ETML-ES-SLO/PRJ_2226_Kit_RegulationThermique/2226A/doc/Canevas Rapport.docx

2226_RegThermique

Pré-étude

Nom du document : 2226_RegThermique_TAN_v1.pdf

Réalisé par : Taulant Neziri

A l'attention de Mr. Braun

Date de début : 30 Novembre 2022

Date de fin : 07 Décembre 2022

# Table des matières

# Cahier des charges

# Pré-étude

## A. Résumé du projet

## B. Schéma général du système

# HMI (Human Machine Interaction)

# Spécifications (Choix technologiques)

## C. Corps de chauffe

ETML-ES 2226_RegThermique TAN Pré-étude
