ETML-ES-SLO/PRJ_2226_Kit_RegulationThermique/2226A/doc/MERGE FINAL/Affiche_2226_Regthermique.pdf

Taulant Neziri
TECHNICIEN-NE ES EN GÉNIE ÉLECTRIQUE / 2022-2023

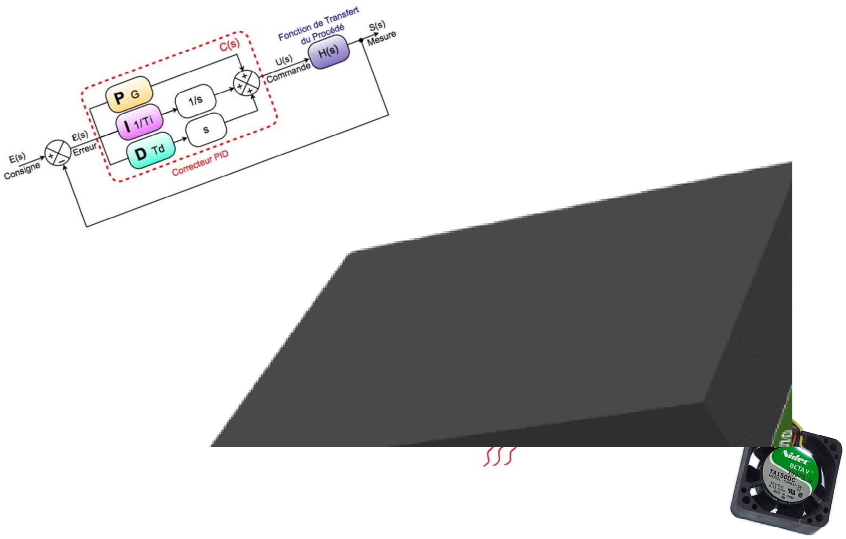
[picture p70: figure]

www.etml-es.ch
rue de Sébeillon 12, 1004 Lausanne | ETML

Régulation thermique

Le but de ce projet est de concevoir un système de régulation thermique dans un boîtier fermé pour les cours de réglage.

L’utilisateur aura deux possibilités de réglages. La première pourra être effectuer via un générateur externe et des touches physiques (bouton, potentiomètre). La deuxième, se fera via USB.

Ce projet m’a permis de développer un produit partant d’une idée sous forme de cahier charges jusqu’à avoir un produit qui pourra être livrable. Le projet n’est pas
complément fini. Les diverses périphériques du système sont fonctionnels, mais la régulation n’a pas pu être traité complètement, et n’est donc pas fonctionnelle.

Malgré les difficultés rencontrés, ce projet m’a apporté de très bonnes connaissances en ce qui concerne la gestion de projet, et a approfondi aussi mes connaissances en dimensionnement et design de schéma électrique ainsi que la conception de PCB.
