ETML-ES-SLO/PRJ_2226_Kit_RegulationThermique/2226A/doc/MERGE FINAL/system_interrupt.pdf

/******************************************************************************* System Interrupts File

File Name:
system_interrupt.c

Summary:
Raw ISR definitions.

Description:
This file contains a definitions of the raw ISRs required to support the interrupt sub-system.

Summary:
This file contains source code for the interrupt vector functions in the system.

Description:
This file contains source code for the interrupt vector functions in the system. It implements the system and part specific vector "stub" functions from which the individual "Tasks" functions are called for any modules executing interrupt-driven in the MPLAB Harmony system.

Remarks:
This file requires access to the systemObjects global data structure that contains the object handles to all MPLAB Harmony module objects executing interrupt-driven in the system. These handles are passed into the individual module "Tasks" functions to identify the instance of the module to maintain. *******************************************************************************/

// DOM-IGNORE-BEGIN
/******************************************************************************* Copyright (c) 2011-2014 released Microchip Technology Inc. All rights reserved.

Microchip licenses to you the right to use, modify, copy and distribute Software only when embedded on a Microchip microcontroller or digital signal controller that is integrated into your product or third party product (pursuant to the sublicense terms in the accompanying license agreement).

You should refer to the license agreement accompanying this Software for additional information regarding your rights and obligations.

SOFTWARE AND DOCUMENTATION ARE PROVIDED "AS IS" WITHOUT WARRANTY OF ANY KIND, EITHER EXPRESS OR IMPLIED, INCLUDING WITHOUT LIMITATION, ANY WARRANTY OF

C:/microchip/harmony/v2_06/apps/MINF/PROJ_RegTherm/firmware/src/system_config/default/system_interrupt.c

1.1 of 6 | 2023.05.24 09:24:42

C:/microchip/harmony/v2_06/apps/MINF/PROJ_RegTherm/firmware/src/system_config/default/system_interrupt.c

1.2 of 6 | 2023.05.24 09:24:42

MERCHANTABILITY, TITLE, NON-INFRINGEMENT AND FITNESS FOR A PARTICULAR PURPOSE. IN NO EVENT SHALL MICROCHIP OR ITS LICENSORS BE LIABLE OR OBLIGATED UNDER CONTRACT, NEGLIGENCE, STRICT LIABILITY, CONTRIBUTION, BREACH OF WARRANTY, OR OTHER LEGAL EQUITABLE THEORY ANY DIRECT OR INDIRECT DAMAGES OR EXPENSES INCLUDING BUT NOT LIMITED TO ANY INCIDENTAL, SPECIAL, INDIRECT, PUNITIVE OR CONSEQUENTIAL DAMAGES, LOST PROFITS OR LOST DATA, COST OF PROCUREMENT OF SUBSTITUTE GOODS, TECHNOLOGY, SERVICES, OR ANY CLAIMS BY THIRD PARTIES (INCLUDING BUT NOT LIMITED TO ANY DEFENSE THEREOF), OR OTHER SIMILAR COSTS. *******************************************************************************/ // DOM-IGNORE-END

// ***************************************************************************** // ***************************************************************************** // Section: Included Files
// ***************************************************************************** // *****************************************************************************

#include "system/common/sys_common.h"

#include "app.h"

#include "system_definitions.h"

// ***************************************************************************** // ***************************************************************************** // Section: System Interrupt Vector Functions
// ***************************************************************************** // *****************************************************************************

void __ISR(_TIMER_1_VECTOR, ipl2AUTO) IntHandlerDrvTmrInstance0(void) {
PLIB_INT_SourceFlagClear(INT_ID_0,INT_SOURCE_TIMER_1);

static int count= 0;

if(count < 3000)
{
count ++;
}
else
{
APP_UpdateState(APP_STATE_SERVICE_TASKS); }

C:/microchip/harmony/v2_06/apps/MINF/PROJ_RegTherm/firmware/src/system_config/default/system_interrupt.c

2.1 of 6 | 2023.05.24 09:24:42

C:/microchip/harmony/v2_06/apps/MINF/PROJ_RegTherm/firmware/src/system_config/default/system_interrupt.c

2.2 of 6 | 2023.05.24 09:24:42

}
void __ISR(_TIMER_2_VECTOR, ipl1AUTO) IntHandlerDrvTmrInstance1(void) {
PLIB_INT_SourceFlagClear(INT_ID_0,INT_SOURCE_TIMER_2);
}
void __ISR(_TIMER_3_VECTOR, ipl1AUTO) IntHandlerDrvTmrInstance2(void) {
PLIB_INT_SourceFlagClear(INT_ID_0,INT_SOURCE_TIMER_3);
}

/******************************************************************************* End of File
*/

C:/microchip/harmony/v2_06/apps/MINF/PROJ_RegTherm/firmware/src/system_config/default/system_interrupt.c

3.1 of 6 | 2023.05.24 09:24:42

C:/microchip/harmony/v2_06/apps/MINF/PROJ_RegTherm/firmware/src/system_config/default/system_interrupt.c

3.2 of 6 | 2023.05.24 09:24:42
