ETML-ES-SLO/PRJ_2226_Kit_RegulationThermique/2226A/hard/2226_RegThermique_BOM.xlsx

2226_RegThermique BOM
Designation | Qty | Description | Package Type | Mfr.Part No. | Supplier.Part No. | Price (per unit) | Total price | Supplier
U4 | 1 | PIC32MX250F128D-I/PT | TQFP-PT44 | PIC32MX250F128DT-I/PT | 579-32MX250F128DTIPT | 5.20 CHF | 5.20 CHF | Mouser
U1,U2,U3 | 3 | MAX6612MXK+T | SOT23 | MAX6612MXK+T | 700-MAX6612MXKT | 2.09 CHF | 6.27 CHF | Mouser
U5,U6,U7 | 3 | TL052ACD | SOIC8 | TL052ACDR | 595-TL052ACDR | 2.15 CHF | 6.45 CHF | Mouser
U8,U9 | 2 | MAX5033AUSA | SOIC8 | MAX5033AUSA+ | 700-MAX5033AUSA | 3.87 CHF | 7.74 CHF
C1,C4 | 2 | 22pF 10% | 0805 | 0805N220K500CT | 791-0805N220K500CT | 0.11 CHF | 0.21 CHF | Mouser
C6 | 1 | 100pF 5% | 0805 | VJ0805D101JXPAJ | 77-VJ0805D101JXPAJ | 0.43 CHF | 0.43 CHF | Mouser
C3,C7,C14 | 3 | 1nF 10% | 0805 | VJ0805Y102KXBBP31X | 77-V0805Y102KXBBP31X | 0.23 CHF | 0.70 CHF | Mouser
C8,C15,C16,C17,C19 C21,C22,C24 | 8 | 100nF 10% | 0805 | VJ0805Y104KBABE31 | 77-VJ0805Y104KBABE31 | 0.48 CHF | 3.87 CHF
C33 | 1 | 0,047uF 10% | 0805 | C0805C473K2RACTU | 80-C0805C473K2RACTU | 0.36 CHF | 0.36 CHF | Mouser
C2,C5,C9,C10,C11,C12,C13,C27,C28,C31,C32 | 11 | 0,1uF 10% | 0805 | C0805C104K8RACAUTO | 80-C0805C104K8RAUTO | 0.09 CHF | 1.02 CHF | Mouser
C29, C30 | 2 | 33uF 20% | 0805 | C2012X5R1A336M125AC | 810-C2012X5R1A336M | 0.77 CHF | 1.54 CHF | Mouser
C25, C26 | 2 | 47uF 20% | 0805 | CL21X476MQYNNWE | 187-CL21X476MQYNNWE | 0.56 CHF | 1.12 CHF | Mouser
R9 | 1 | 33R 10% | 0805 | SG732ATTD330K | 660-SG732ATTD330K | 0.34 CHF | 0.34 CHF | Mouser
R5 | 1 | 100R 10% | 0805 |  |  |  | 0.00 CHF | Mouser
 |  | 200R 10% | 0805 |  |  |  | 0.00 CHF
 |  | 270R 10% | 0805 |  |  |  | 0.00 CHF
R4,R22,R23,R25,R26,R27,R28,R29,R30,R31,R32,R33,R36,R37 | 14 | 1k 10% | 0805 | TR0805KR-071KL | 603-TR0805KR-071KL | 0.28 CHF | 3.91 CHF | Mouser
R16 | 1 | 1k8 5% | 0805 | ERJ-P06J182V | 667-ERJ-P06J182V | 0.12 CHF | 0.12 CHF | Mouser
R3,R6,R7,R8,R10,R11,R13,R14,R17,R18,R22,R27, R31,R41, | 14 | 10k 10% | 0805 | SG732ATTD103K | 660-SG732ATTD103K | 0.34 CHF | 4.76 CHF | Mouser
R12 | 1 | 10k 10% (POT) | VR5 |  |  |  | 0.00 CHF
R38, R39 | 2 | 15k 10% | 0805 | ERJ-HP6D1502V | 667-ERJ-HP6D1502V | 0.41 CHF | 0.82 CHF | Mouser
R35 | 1 | 24k 0.5% | 0805 | CR0805-JW-243ELF | 652-CR0805JW-243ELF | 0.09 CHF | 0.09 CHF | Mouser
R34 | 1 | 47k 1% | 0805 | ERJ-S06F4702V | 667-ERJ-S06F4702V | 0.37 CHF | 0.37 CHF | Mouser
R19,R24,R40 | 3 | 100k 10% | 0805 |  |  |  | 0.00 CHF
R20,R21,R22,R23,R26,R27,R29,R30,R31 | 9 | No value | THT 0.4 | SL-102-G-12 | 200-SL102G12 |  | 0.00 CHF
C17,C23 | 2 | No value | THT 0.4 | SL-102-G-12 | 200-SL102G12 |  | 0.00 CHF
Q1,Q2 | 2 | PNP | SOT23B_N |  |  |  | 0.00 CHF
Q3,Q4,Q5 | 2 | NPN | SOT23 | IRLML2030TRPBF | 942-IRLML2030TRPBF | 0.39 CHF | 0.78 CHF | Mouser
D1 | 1 | Super Red (1,9V) | 0805 | LS R976-NR-1 | 720-LSR976-NR-1 | 0.28 CHF | 0.28 CHF | Mouser
D2 | 1 | Bright Green (2V) | 0805 | LG R971 | 720-LGR971-KN-1 | 0.28 CHF | 0.28 CHF | Mouser
D4 | 1 | 1N4007 | DO-213AA | EGL1B | 637-EGL1B | 0.87 CHF | 0.87 CHF | Mouser
D5,D6 | 2 | BAT165-HG3/H | DO-219AC-2 | BAT165-HG3/H | 78-BAT165-HG3/H | 0.36 CHF | 0.72 CHF | Mouser
B1 | 1 | Ecran LCD | NHD-0420AZ-FSW-GBW-33V3 | NHD-0420AZ-FSW-GBW-33V3 | 763-0420AZFSWGBW33V3 | 20.47 CHF | 20.47 CHF | Mouser
S2 | 1 | Pec12r | XDCR_PEC12R-2220F-S0024 | PEC12R-4215F-S0024 | 652-PEC12R-4215F-S24 | 1.40 CHF | 1.40 CHF | Mouser
L1,L2 | 2 | 220uH | AEC-Q200 | 74404086221 | 710-74404086221 | 1.29 CHF | 2.58 CHF | Mouser
X1 | 1 | Banane RED | 4mm Rouge 36A | RND 350-00059 | 301-57-881 | 2.30 CHF | 2.30 CHF | Distrelec
X2 | 1 | Banane BLACK | 4mm Noir 36A | RND 350-00058 | 301-57-880 | 2.30 CHF | 2.30 CHF | Distrelec
X3 | 1 | Banane BLUE | 4mm Bleu 36A | RND 350-00060 | 301-57-882 | 2.20 CHF | 2.20 CHF | Distrelec
X4,X8,X9,X10 | 4 | Jumper | Header 2 | Stock ES | Stock ES | 0.09 CHF | 0.36 CHF | Mouser
P1,P2,P3,P4,P5,P6 | 6 | Jumper | Header 2 | Stock ES | Stock ES | 0.09 CHF | 0.54 CHF | Mouser
TP1,TP2,TP3 | 3 |  | KSTN-5019_V | 5019 | 534-5019 | 0.32 CHF | 0.96 CHF | Mouser
3V3,5V,+15V,-15V,GND | 8 |  | KSTN-5019_V | 5019 | 534-5019 | 0.32 CHF | 2.56 CHF | Mouser
LCD | 1 | LCD header connector | Header 16 | Stock ES | Stock ES
J1 | 1 | Debug Connector | Header 6 | Stock ES | Stock ES |  | 0.00 CHF
Y1 | 1 | 8MHz,12p | FOX-FOXSDLF160-20_V | 830003151 | 710-830003151 | 0.54 CHF | 0.54 CHF | Mouser
SW1 | 1 | WS-TASV SMD Tact Switch 6X6 mm | 430182043816 | 430182043816 | 710-430182043816 | 0.49 CHF | 0.49 CHF | Mouser
 |  |  |  |  |  | Total price : | 84.96 CHF
