ETML-ES-SLO/PRJ_2226_Kit_RegulationThermique/2226A/hard/BOM/BOM__Digikey_RegThermique.xlsx

Quantity | Article | Description | Prix | Total | Supplier
5 | ED10251-ND | Capacitor | 0.69 CHF | 3.45 CHF | Digi-Key
18 | ED10251-ND | Resistor | 0.69 CHF | 12.42 CHF | Digi-Key
15 | 36-5019TR-ND | Test Point, 1 Position SMD, RoHS, Tape and Reel | 0.32 CHF | 4.80 CHF | Digi-Key
