ETML-ES-SLO/PRJ_2226_Kit_RegulationThermique/2226A/hard/BOM/BOM__Distrelec_RegThermique.csv

Quantity | Article | Description | Prix
1 | 301-57-881 | Socle banane 4mm Rouge | 2.3
1 | 301-57-880 | Socle banane 4mm Noir | 2.3
1 | 301-57-882 | Socle banane 4mm Bleu | 2.3
