ETML-ES-SLO/PRJ_2226_Kit_RegulationThermique/2226A/hard/BOM/BOM__ES_RegThermique.xlsx

Article | Description | Quantity | Prix | Total | Supplier
Stock ES | CONN HEADER VERT 2POS 2.54MM | 4 | 0.13 CHF | 0.52 CHF | ES
Stock ES | Header, 2-Pin | 9 | 0.11 CHF | 0.99 CHF | ES
Stock ES | WR-PHD Pin Header, THT, pitch 2.54mm, Single Row, Vertical, 6pin | 1 | 0.26 CHF | 0.26 CHF | ES
