ETML-ES-SLO/PRJ_2226_Kit_RegulationThermique/2226A/hard/BOM/BOM__Mouser_RegThermique.xlsx

Quantity | Article | Description | Prix | Total | Supplier
1 | 763-0420AZFSWGBW33V3 | LCD Character Display Modules & Accessories STN- GRAY Transfl 77.5 x 47.0 | 20.47 CHF | 20.47 CHF | Mouser
3 | 791-0805N220K500CT | CAP 22pF 10V | 0.11 CHF | 0.33 CHF | Mouser
20 | 77-VJ0805Y104KBABE31 | Cap 100nF | 0.48 CHF | 9.60 CHF | Mouser
3 | 77-V0805Y102KXBBP31X | Cap 1nF | 0.23 CHF | 0.69 CHF | Mouser
3 | 187-CL21X476MQYNNWE | Cap Pol 47uF | 0.56 CHF | 1.68 CHF | Mouser
3 | 810-C2012X5R1A336M | Cap Pol 33uF | 0.77 CHF | 2.31 CHF | Mouser
2 | 80-C0805C473K2RACTU | Cap 0.047uF | 0.36 CHF | 0.72 CHF | Mouser
1 | 720-LSR976-NR-1 | SMT Mono-color Chip LED Waterclear WL-SMCW, size 0805, Super Red, 1.9 V, 140 deg, 60 mcd | 0.28 CHF | 0.28 CHF | Mouser
1 | 720-LGR971-KN-1 | SMT Mono-color Chip LED Waterclear WL-SMCW, size 0805, Bright Green, 2 V, 140 deg, 40 mcd | 0.28 CHF | 0.28 CHF | Mouser
1 | 637-EGL1B | Diode Melf : EGL1B (100V,1A) | 0.87 CHF | 0.87 CHF | Mouser
2 | 78-BAT165-HG3/H | Schottky Diode 50SQ100 | 0.36 CHF | 0.72 CHF | Mouser
2 | 710-74404086221 | Inductor 220uH | 1.29 CHF | 2.58 CHF | Mouser
2 | 771-2PB709ARL,235 | PNP Bipolar Transistor | 0.11 CHF | 0.22 CHF | Mouser
3 | 942-IRLML2030TRPBF | N-Channel MOSFET | 0.39 CHF | 1.17 CHF | Mouser
2 | 71-CRCW0805-270 | Res 270R | 0.15 CHF | 0.30 CHF | Mouser
11 | 660-SG732ATTD103K | Res 10K | 0.34 CHF | 3.74 CHF | Mouser
7 | 603-TR0805KR-071KL | Res 1K | 0.28 CHF | 1.96 CHF | Mouser
1 | 810-C2012X5R1A336M | Res 33R | 0.77 CHF | 0.77 CHF | Mouser
1 | 652-3362P-1-102LF | Pot 10K | 0.96 CHF | 0.96 CHF | Mouser
1 | 603-RC0805FR-07200RL | Res 200R | 0.09 CHF | 0.09 CHF | Mouser
1 | 667-ERJ-P06J182V | Res 1K8 | 0.12 CHF | 0.12 CHF | Mouser
5 | 603-RC0805FR-07100KL | Res 100K | 0.09 CHF | 0.46 CHF | Mouser
1 | 652-CR0805JW-243ELF | Res 24K | 0.09 CHF | 0.09 CHF | Mouser
1 | 667-ERJ-HP6D1502V | Res 15K | 0.41 CHF | 0.41 CHF | Mouser
1 | 652-PEC12R-4215F-S24 | Rotary Encoder Mechanical 24 Quadrature (Incremental) Right Angle | 1.40 CHF | 1.40 CHF | Mouser
1 | 710-430182043816 | WS-TASV SMD Tact Switch 6X6 mm | 0.49 CHF | 0.49 CHF | Mouser
3 | 700-MAX6612MXKT | High-Slope, Low-Power, Analog Temperature Sensor, -55 to 150 degC, 5-Pin SOT23 (X5+1), Pb-Free | 2.09 CHF | 6.27 CHF | Mouser
1 | 579-32MX250F128DTIPT | 32-bit Microcontroller with Audio and Graphics Interface, USB and Advanced Analog, 50 MHz, 33 I/O, PMP, -40 to 85 degC, 44-pin TQFP (PT44), Tray | 5.20 CHF | 5.20 CHF | Mouser
3 | 595-TL052ACDR | Enhanced JFET Precision Dual Operational Amplifier, 10 to 30 V, 0 to 70 degC, 8-pin SOIC (D8), Green (RoHS & no Sb/Br) | 2.15 CHF | 6.45 CHF | Mouser
2 | 700-MAX5033AUSA | 500mA, 76V, High-Efficiency, MAXPower(TM) Step-Down DC-DC Converter, 3.3V output, 8-Pin SOIC, 0°C to +85°C | 3.87 CHF | 7.74 CHF | Mouser
1 | 700-MAX7315AUET | IC I/O EXPANDER I2C 8B 16TSSOP | 4.22 CHF | 4.22 CHF | Mouser
1 | 710-830003151 | Resistance Weld SMD Crystal, 8 MHz, +/- 30 ppm, 12 pF, -20 to 70 degC, 2-Pin SMD, RoHS, Tape and Reel | 0.54 CHF | 0.54 CHF | Mouser
5 | 470-1699670000 | Connecteur clamp 2 pos. | 1.39 CHF | 6.95 CHF | Mouser
