ETML-ES-SLO/PRJ_2226_Kit_RegulationThermique/2226A/hard/NoProjet_NomProjet-BOM-v1.XLS

ETML
Refs | Nb | Désignation | Type | Valeur | Fournisseur | N° de commande | Prix u / 1 | Prix u / 10 | Prix u / 100 | Prix u / 1000 | Unité(s) d'emballage | Prix u / unité d'emballage | Prix de référence | Choix | Prix tot | Remarques
X1,X2 | 2 | Connecteur header pour câble plat DIN 41 651 sans bride de rétension | 3421-7600 | 20 pôles | Sasco Spoerle | 238221 |  |  | 2.450 | 2.150 | 100 | 2.450 | / un emb | * | 4.900 | p 3-23.002
 |  |  |  |  |  |  |  |  |  |  |  |  | -
 | 0.14 | m de câble plat 20 pôles | 3365-20 | 20 pôles | Sasco Spoerle | 270327 | 2.050 |  | 1.10 | 0.860 | 91m | 1.100 | / un emb | * | 0.154 | p3-26.029
 |  |  |  |  |  |  |  |  |  |  |  |  | -
 | 1 | montage |  |  | CIP |  |  |  |  |  |  |  | -
 |  |  |  |  | GXE |  |  | 4.000 | 3.000 |  |  |  | / 10 | * | 4.000
 |  |  |  |  |  |  |  |  |  |  |  |  | - | * | 0
 |  |  |  |  |  |  |  |  |  |  |  |  | -
 |  |  |  |  |  |  |  |  |  |  |  |  | - | * | 0
 |  |  |  |  |  |  |  |  |  |  |  |  | -
 |  |  |  |  |  |  |  |  |  |  |  |  | - | * | 0
 |  |  |  |  |  |  |  |  |  |  |  |  | -
 |  |  |  |  |  |  |  |  |  |  |  |  | - | * | 0
 |  |  |  |  |  |  |  |  |  |  |  |  | -
 |  |  |  |  |  |  |  |  |  |  |  |  | - | * | 0
 |  |  |  |  |  |  |  |  |  |  |  |  | -
 |  |  |  |  |  |  |  |  |  |  |  |  | - | * | 0
 |  |  |  |  |  |  |  |  |  |  |  |  | -
 |  |  |  |  |  |  |  |  |  |  |  |  | - | * | 0
 |  |  |  |  |  |  |  |  |  |  |  |  | -
 |  |  |  |  |  |  |  |  |  |  |  |  | - | * | 0
 |  |  |  |  |  |  |  |  |  |  |  |  | -
 |  |  |  |  |  |  |  |  |  |  |  |  | - | * | 0
 |  |  |  |  |  |  |  |  |  |  |  |  | -
 |  |  |  |  |  |  |  |  |  |  |  |  | - | * | 0
 |  |  |  |  |  |  |  |  |  |  |  |  | -
 |  |  |  |  |  |  |  |  |  |  |  |  | - | * | 0
 |  |  |  |  |  |  |  |  |  |  |  |  | -
 |  |  |  |  |  |  |  |  |  |  |  |  | - | * | 0
 |  |  |  |  |  |  |  |  |  |  |  |  | -
 |  |  |  |  |  |  |  |  |  |  |  |  | - | * | 0
 |  |  |  |  |  |  |  |  |  |  |  |  | -
 |  |  |  |  |  |  |  |  |  |  |  |  | - | * | 0
 |  |  |  |  |  |  |  |  |  |  |  |  | -
 |  |  |  |  |  |  |  |  |  |  |  |  | - | * | 0
 |  |  |  |  |  |  |  |  |  |  |  |  | -
 |  |  |  |  |  |  |  |  |  |  |  |  | - | * | 0
 |  |  |  |  |  |  |  |  |  |  |  |  | -
 |  |  |  |  |  |  |  |  |  |  |  |  | - | * | 0
 |  |  |  |  |  |  |  |  |  |  |  |  | -
 |  |  |  |  |  |  |  |  |  |  |  |  |  | Total: | 9.05
