ETML-ES-SLO/PRJ_2226_Kit_RegulationThermique/2226A/hard/BOM/BOM__Distrelec_RegThermique.xlsx

Quantity | Article | Description | Prix
1 | 301-57-881 | Socle banane ø4mm Rouge | 2.3
1 | 301-57-880 | Socle banane ø4mm Noir | 2.3
1 | 301-57-882 | Socle banane ø4mm Bleu | 2.3
