ETML-ES-SLO/PRJ_2226_Kit_RegulationThermique/2226A/hard/2226_RegThermique_1/Project Outputs for 2226_RegThermique/Export/PCB_RegThermique.step

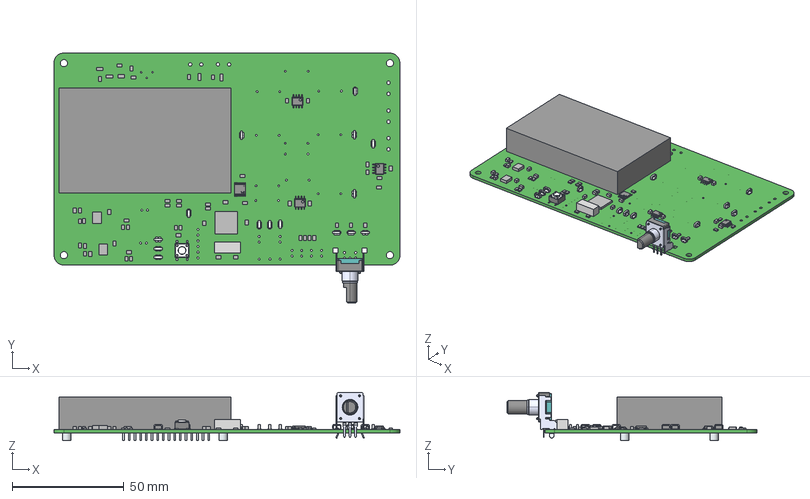
[picture p72: CAD file, 2024-05-14]
2226A/hard/2226_RegThermique_1/Project Outputs for 2226_RegThermique/Export/PCB_RegThermique.step
155.0 x 111.9 x 21.7 mm
Extruded x 63
keystone-PN5019 x 15
4301x20438x6
IC_Maxim_MAX4581AUE-GG8_eec x 3
BODY_M08A_35 x 3
LEAD_M08A_57 x 24
MANIFOLD_SOLID_BREP_2784 x 3
MANIFOLD_SOLID_BREP_2935 x 3
MANIFOLD_SOLID_BREP_3086 x 3
MANIFOLD_SOLID_BREP_3237 x 3
Leads x 20
