ETML-ES-SLO/PRJ_2226_Kit_RegulationThermique/2226A/doc/Journal de bord RegThermique.xlsx

AGENDA
DATE | HEURE | ÉVÉNEMENT
2022-11-16 |  | Prise de connaissance du projet
2022-11-23 |  | Discussion avec M.Braun pour valider les demandes du cahier des charges
2022-11-30 |  | Ecriture du la pré-étude
2022-12-07 |  | Finalisation et rendu de la pré-étude
2022-12-14 |  | Présentation de la pré-étude et début de la conception schématique (design)
2022-12-21 |  | Correction de la pré-étude, avancement de la schématique
2022-12-28 |  | VACANCES
2023-01-04 |  | VACANCES
2023-01-11 |  | Design des blocs "externes" bloc : puissance, capteur
2023-01-18 |  | Design du uC et de son montage minimum nécessaire, bloc alimentation et connecteurs
2023-01-25 |  | Rendu du rapport de design, correction de certaines erreurs schématiques, recherche de footprint
2023-02-01 |  | Recherches de footprint, correction du dimensionnement de certain composants (bloc alimentation, HMI)
2023-02-08 |  | Présentation de la partie conception schématique, début de la correction (selon points indiqué pendant la présentation)
2023-02-15 |  | VACANCES
2023-02-22 |  | Correction du schéme électrique selon les consignes donnée pendant la présentation, recherche des derniers footprints
2023-03-01 |  | Conception du PCB (placement des composants), recherche du boitier en parallèle
2023-03-08 |  | Placement términé, début du routage
2023-03-15 |  | Correction du PCB, placement modifier, création de la Bom afin de contrôler tout les footprints, routage annulé
2023-03-22 |  | Finition du PCB, correction des erreurs dans le DRC, validation avec EuroCircuit, commande du PCB
2023-03-29 |  | Réception et des composants, organisation pour le montage, PCB début du montage
2023-04-05 |  | Commande des PCB externe (capteur, corps de chauffe) et composants ext. Comme : ventilateur
2023-04-12 |  | VACANCES
2023-04-19 |  | VACANCES
2023-04-26 |  | Création du projet soft, communication avec PIC32 fonctionnelle, finissions du PCB principal
2023-05-03 |  | Configuration Harmony des périphériques (timer, OC,ADC)
2023-05-10 |  | Recherche de la panne sur le LCD
2023-05-17 |  | Misen forme de l'affichage LCD
2023-05-24 |  | Lecture ADC fonctionnel mise en forme des valeur reçues
2023-05-31 |  | Ecriture de la communication SPI pour le DAC + Rapport
2023-06-07 |  | Ecriture de la communication SPI pour le DAC + Rapport
2023-06-14
2023-06-21
2023-06-28
