ETML-ES-SLO/PRJ_2226_Kit_RegulationThermique/2226A/hard/2226_RegThermique_1/2226_RegThermique.pdf

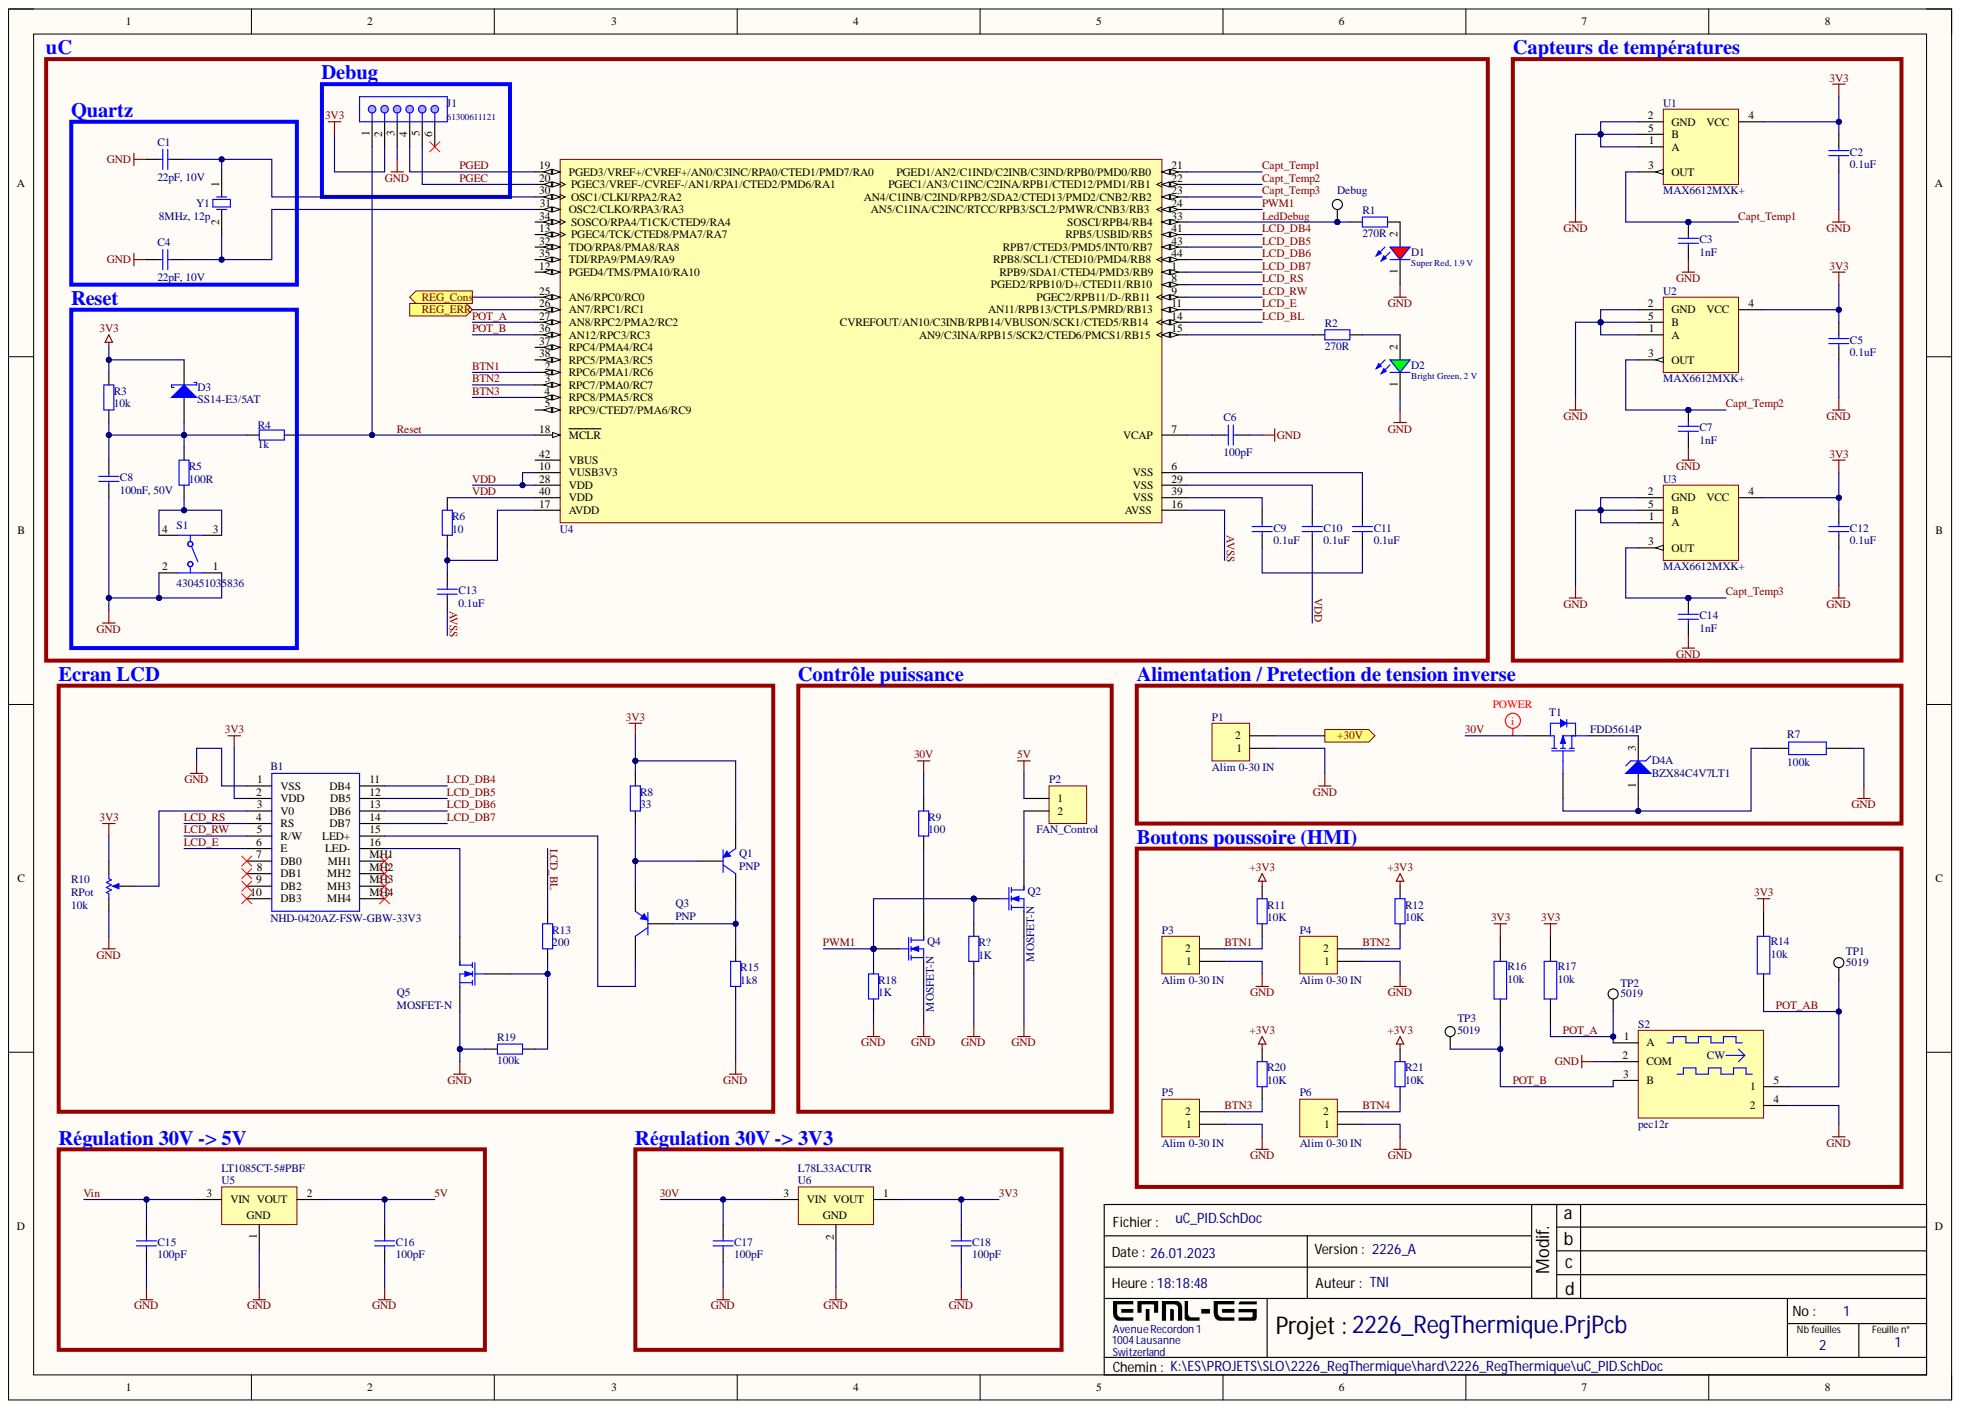
[picture p73: page 1]

Alimentation / Pretection de tension inverse 12

uC_PI D . SchDoc F i chi e r :

abcd

Date : 2 6. 01 . 2023 | Ve rsion : 2 2 2 6_A

H eure : 1 8: 1 8: 48 | Auteur : TNI

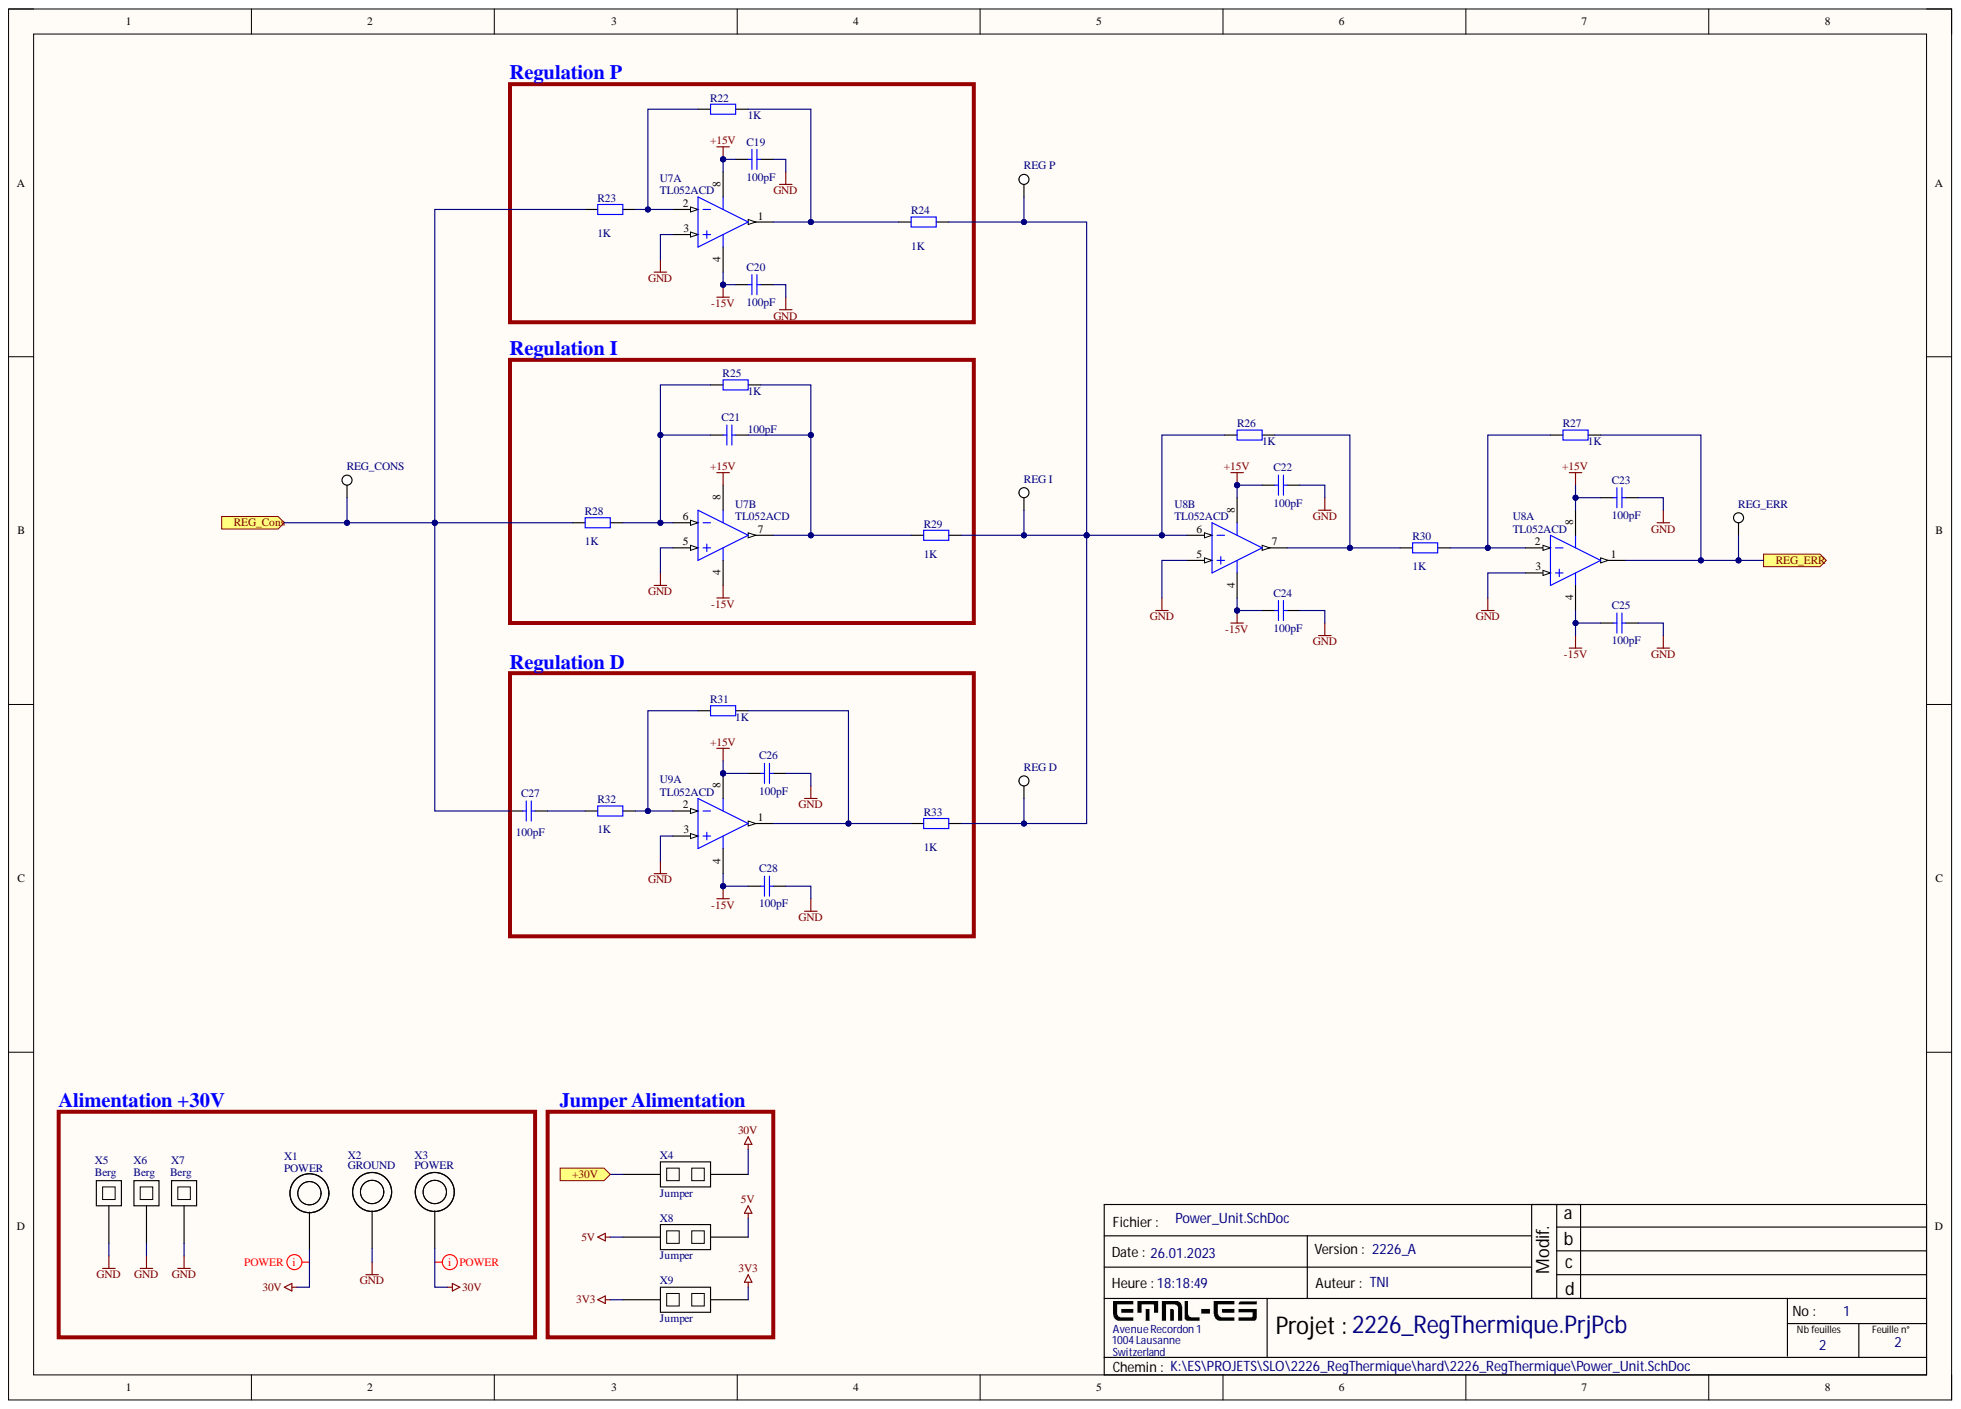
[picture p74: page 2]

Power_Unit.SchDoc Fichier : | a

Heure : 18:18:49 | Auteur : TNI
Avenue Recordon 1 1004 Lausanne Switzerland | Projet : 2226_RegThermique.PrjPcb | No : 1

Nb feuilles 2 | Feuille n° 2

Chemin : K:\ES\PROJETS\SLO\2226_RegThermique\hard\2226_RegThermique\Power_Unit.SchDoc
