ETML-ES-SLO/PRJ_2226_Kit_RegulationThermique/2226A/doc/Fichier CAO/Schematic Prints.PDF

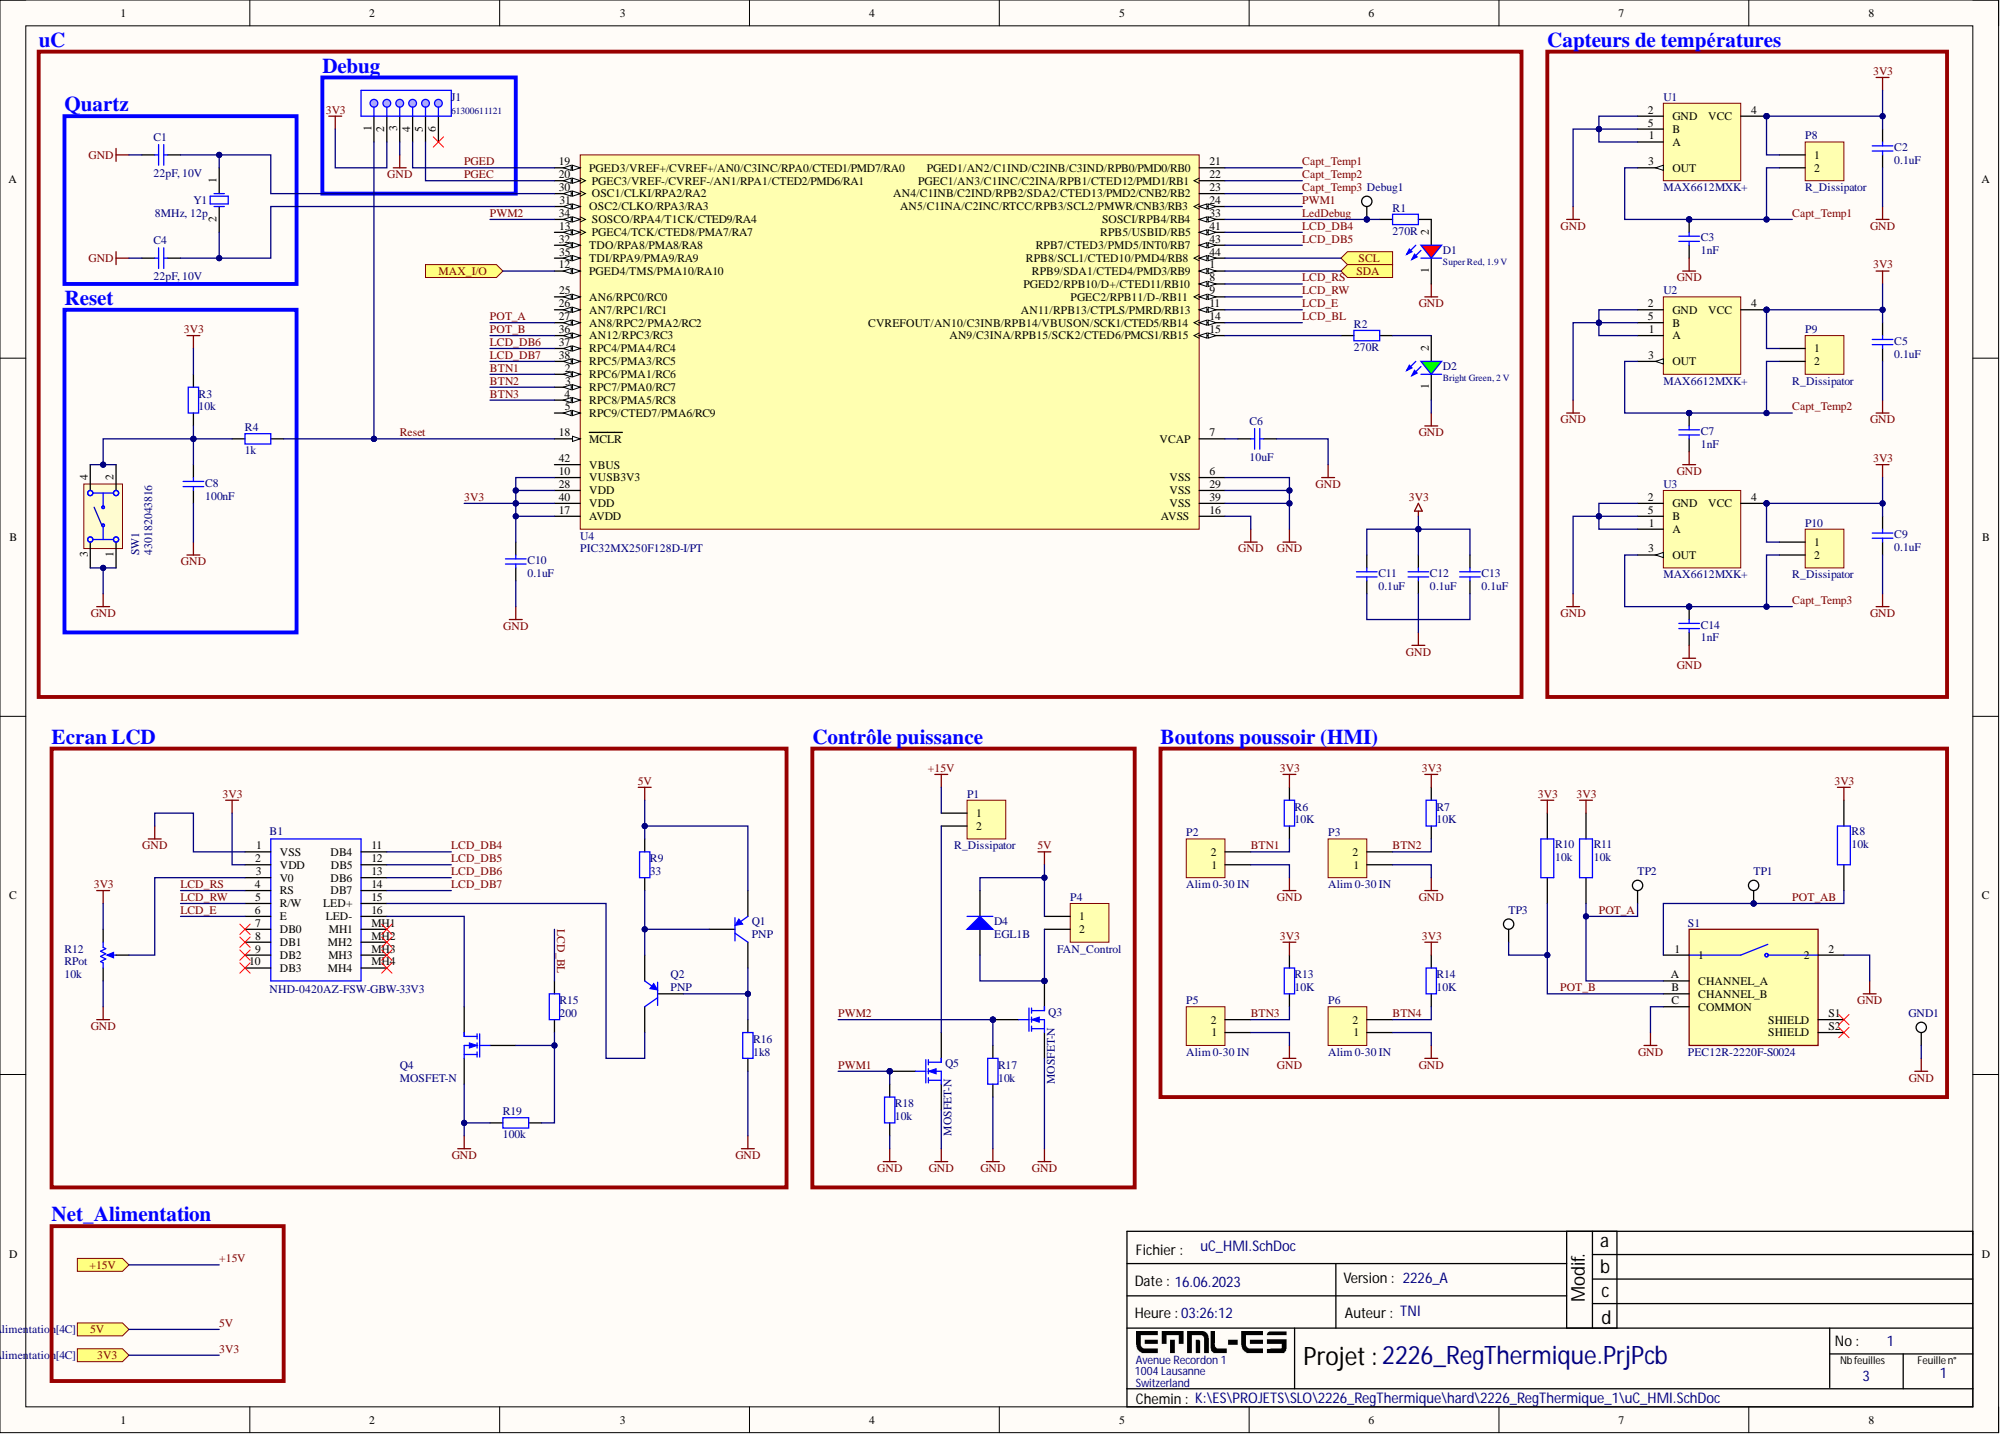
[picture p75: page 1]

uC_HMI.SchDoc Fichier : | | a

Date : 16.06.2023 | Version : 2226_A

Heure : 03:26:12 | TNI Auteur :
Avenue Recordon 1 1004 Lausanne Switzerland | Projet : 2226_RegThermique.PrjPcb | No : 1

Nb feuilles 3 | Feuille n° 1

Chemin : K:\ES\PROJETS\SLO\2226_RegThermique\hard\2226_RegThermique_1\uC_HMI.SchDoc

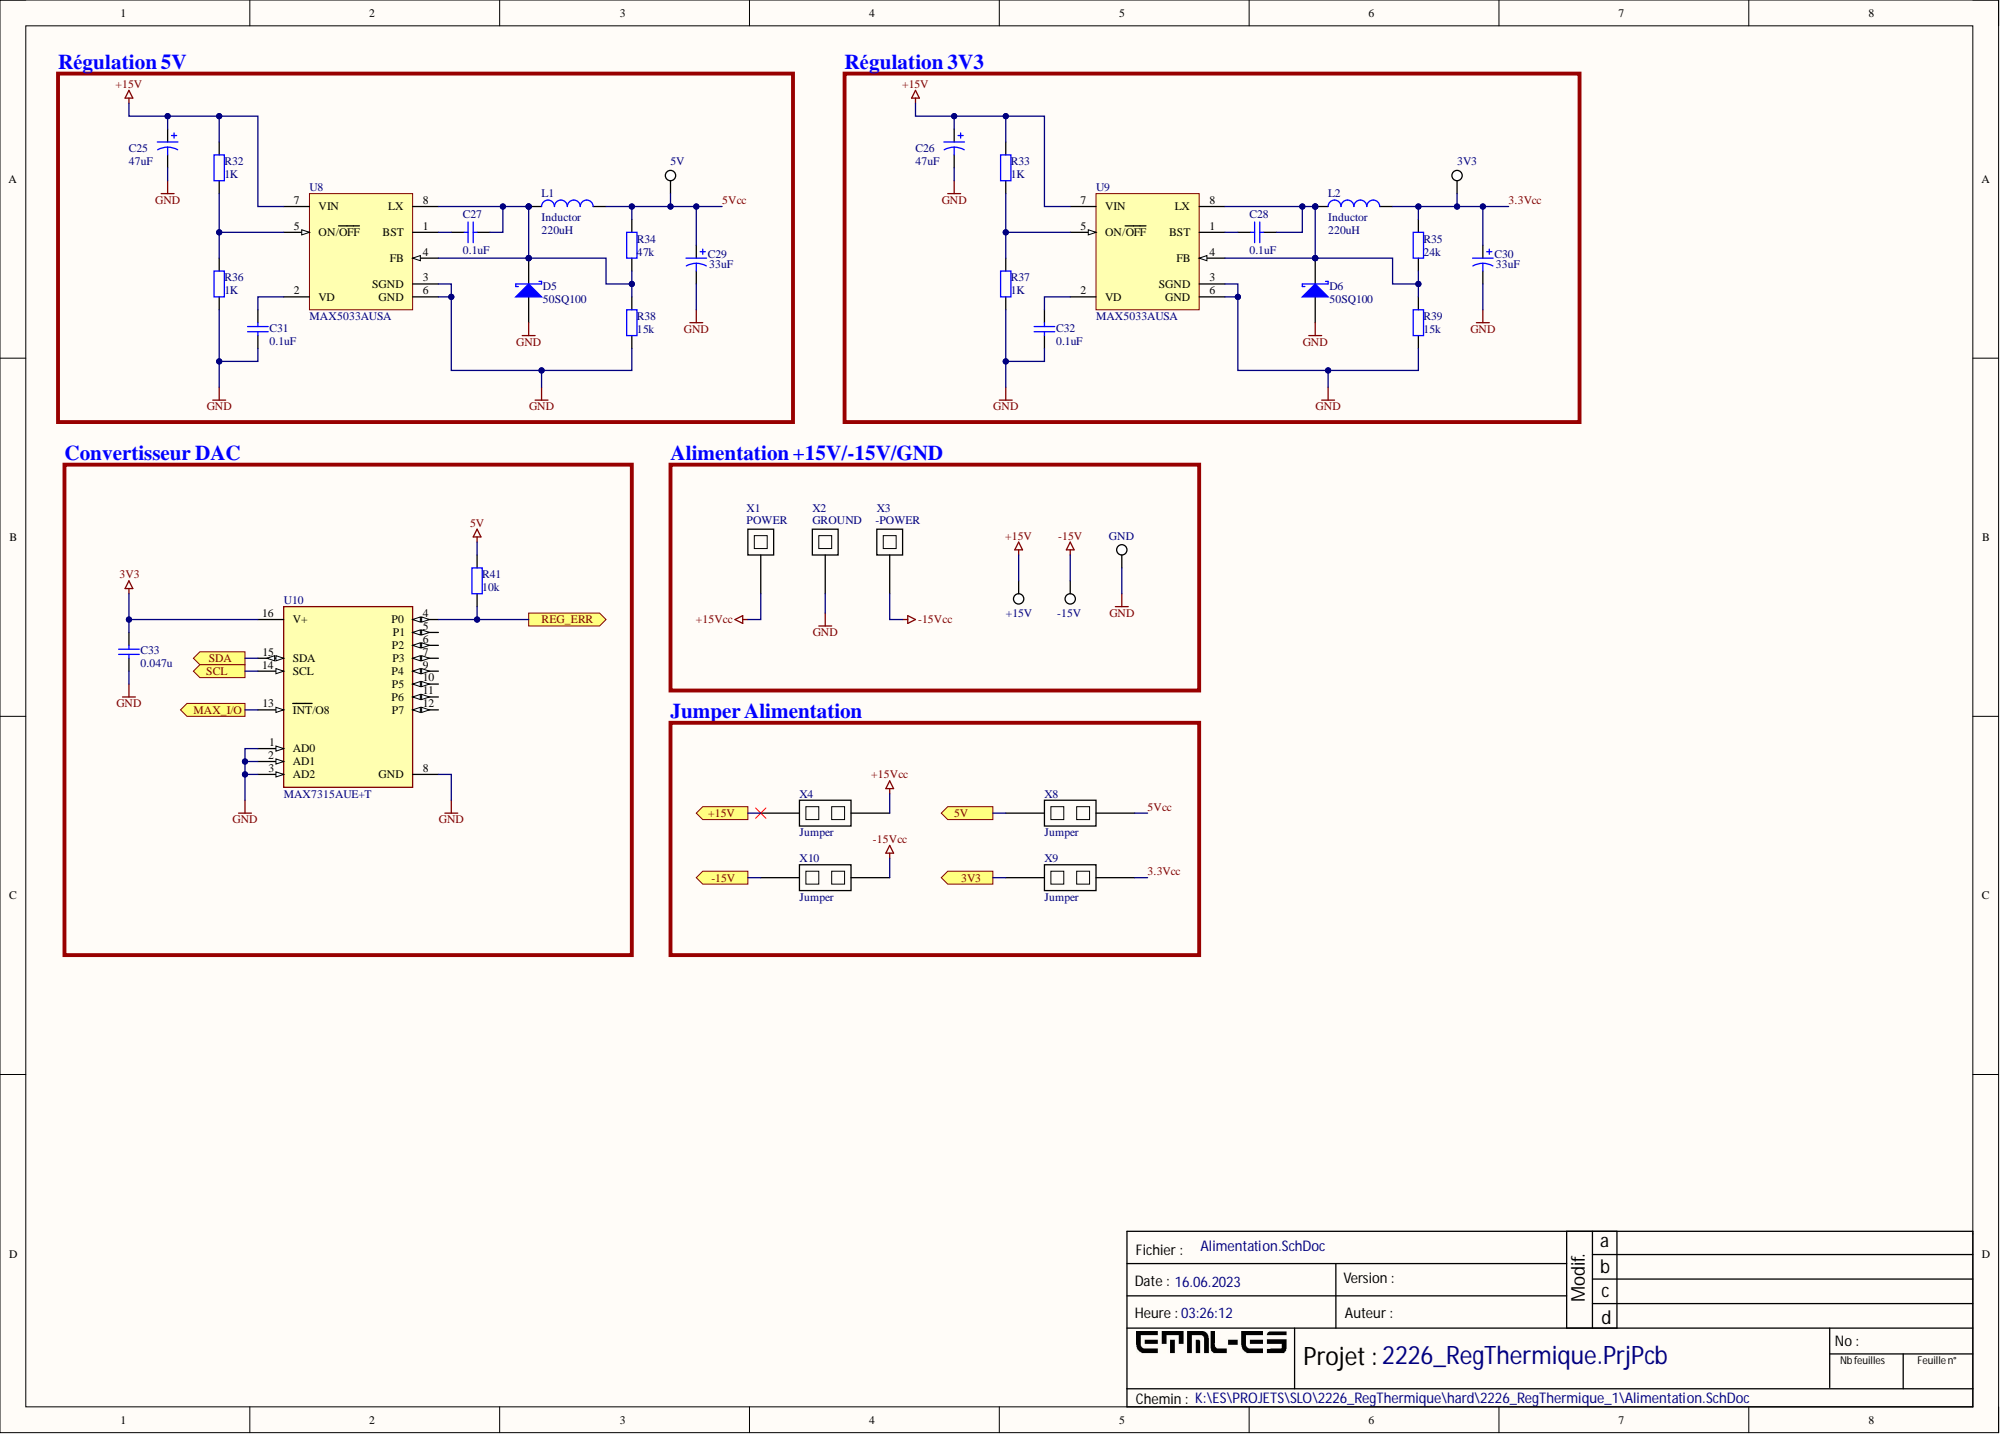
[picture p76: page 2]

Alimentation.SchDoc Fichier : | a

Chemin : K:\ES\PROJETS\SLO\2226_RegThermique\hard\2226_RegThermique_1\Alimentation.SchDoc

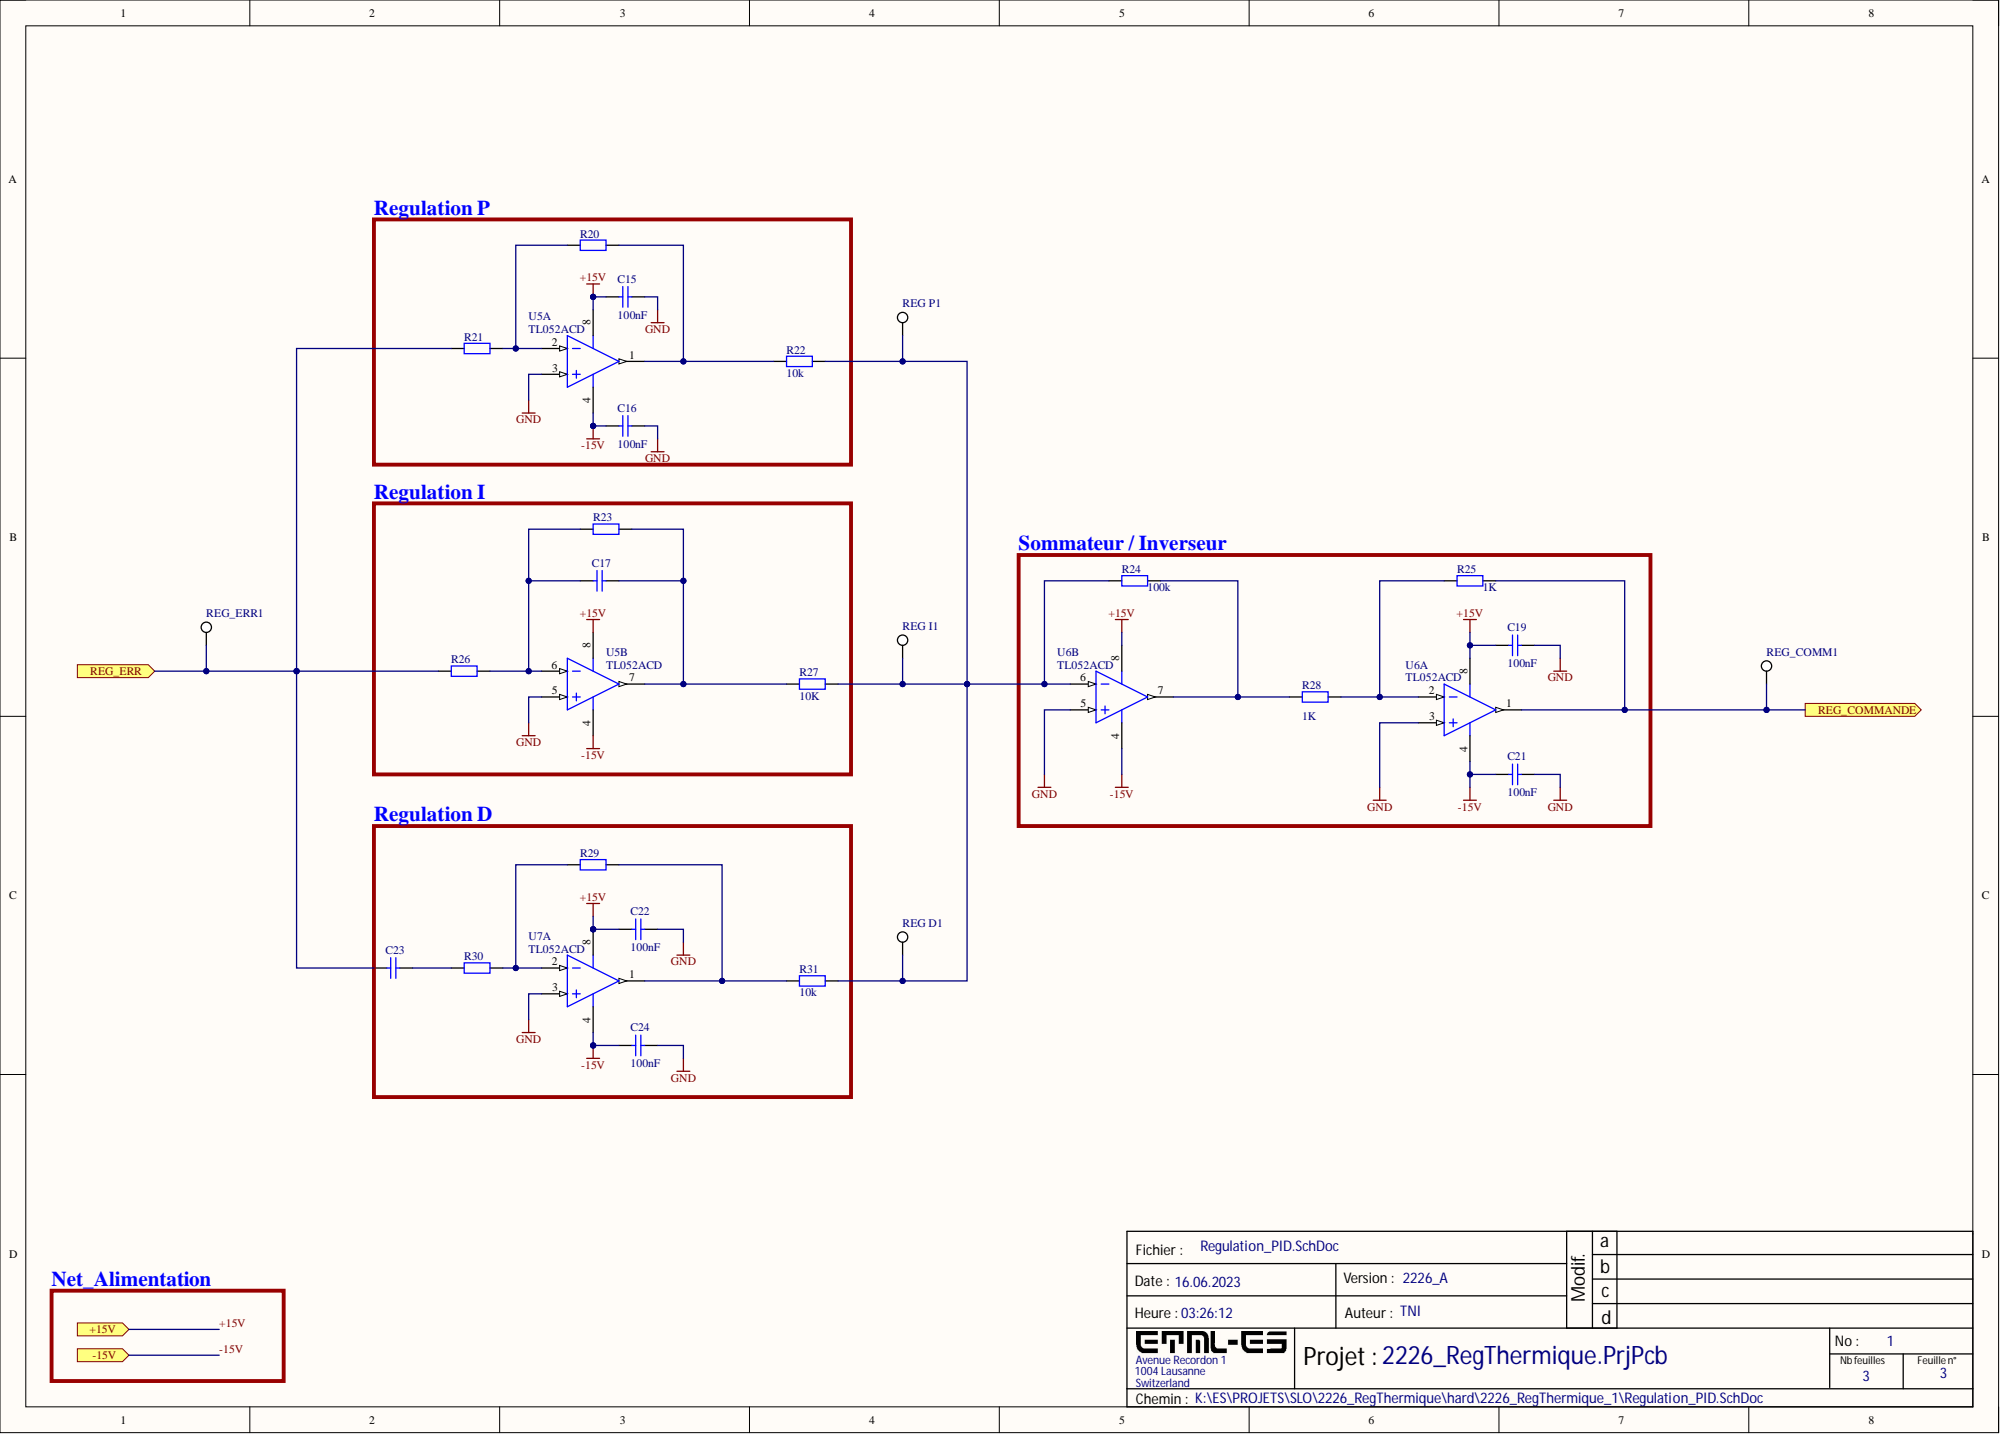
[picture p77: page 3]

Regulation_PID.SchDoc Fichier : | a

Date : 16.06.2023 | Version : 2226_A

TNI

Avenue Recordon 1 1004 Lausanne Switzerland | | No : 1

Chemin : K:\ES\PROJETS\SLO\2226_RegThermique\hard\2226_RegThermique_1\Regulation_PID.SchDoc
