ETML-ES-SLO/PRJ_2226_Kit_RegulationThermique/2226A/hard/2226_RegThermique_1/Project Outputs for 2226_RegThermique/DesignDocs/Dimensional Drawings.PDF

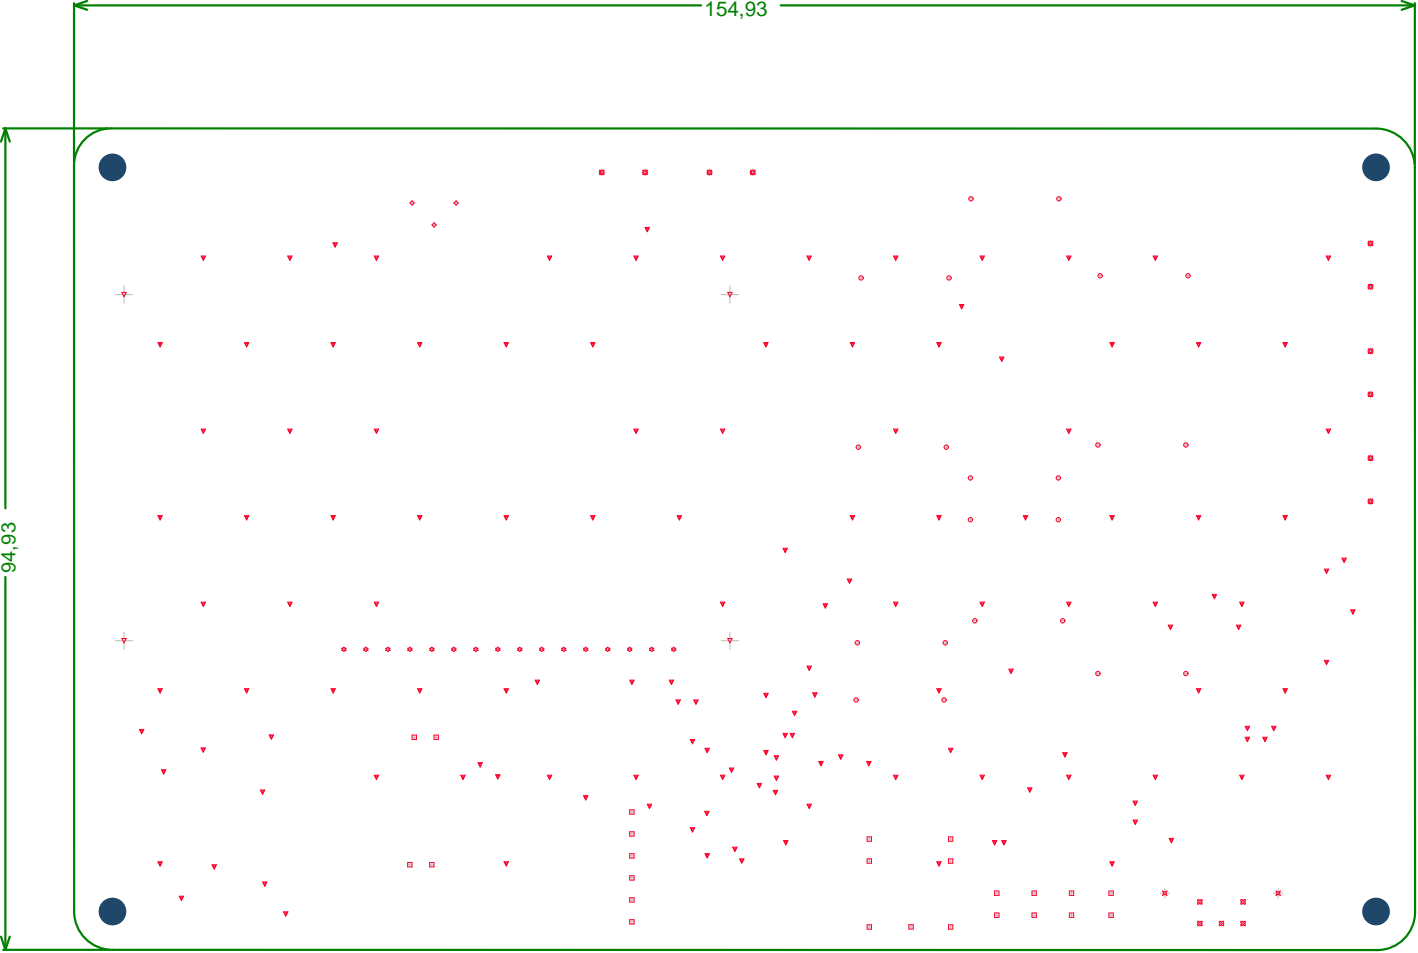
[picture p78: page 1]
