ETML-ES-SLO/PRJ_2226_Kit_RegulationThermique/2226A/hard/2226_RegThermique_1/Project Outputs for 2226_RegThermique/DesignDocs/PCB Top-Bottom Assy Dwgs.PDF

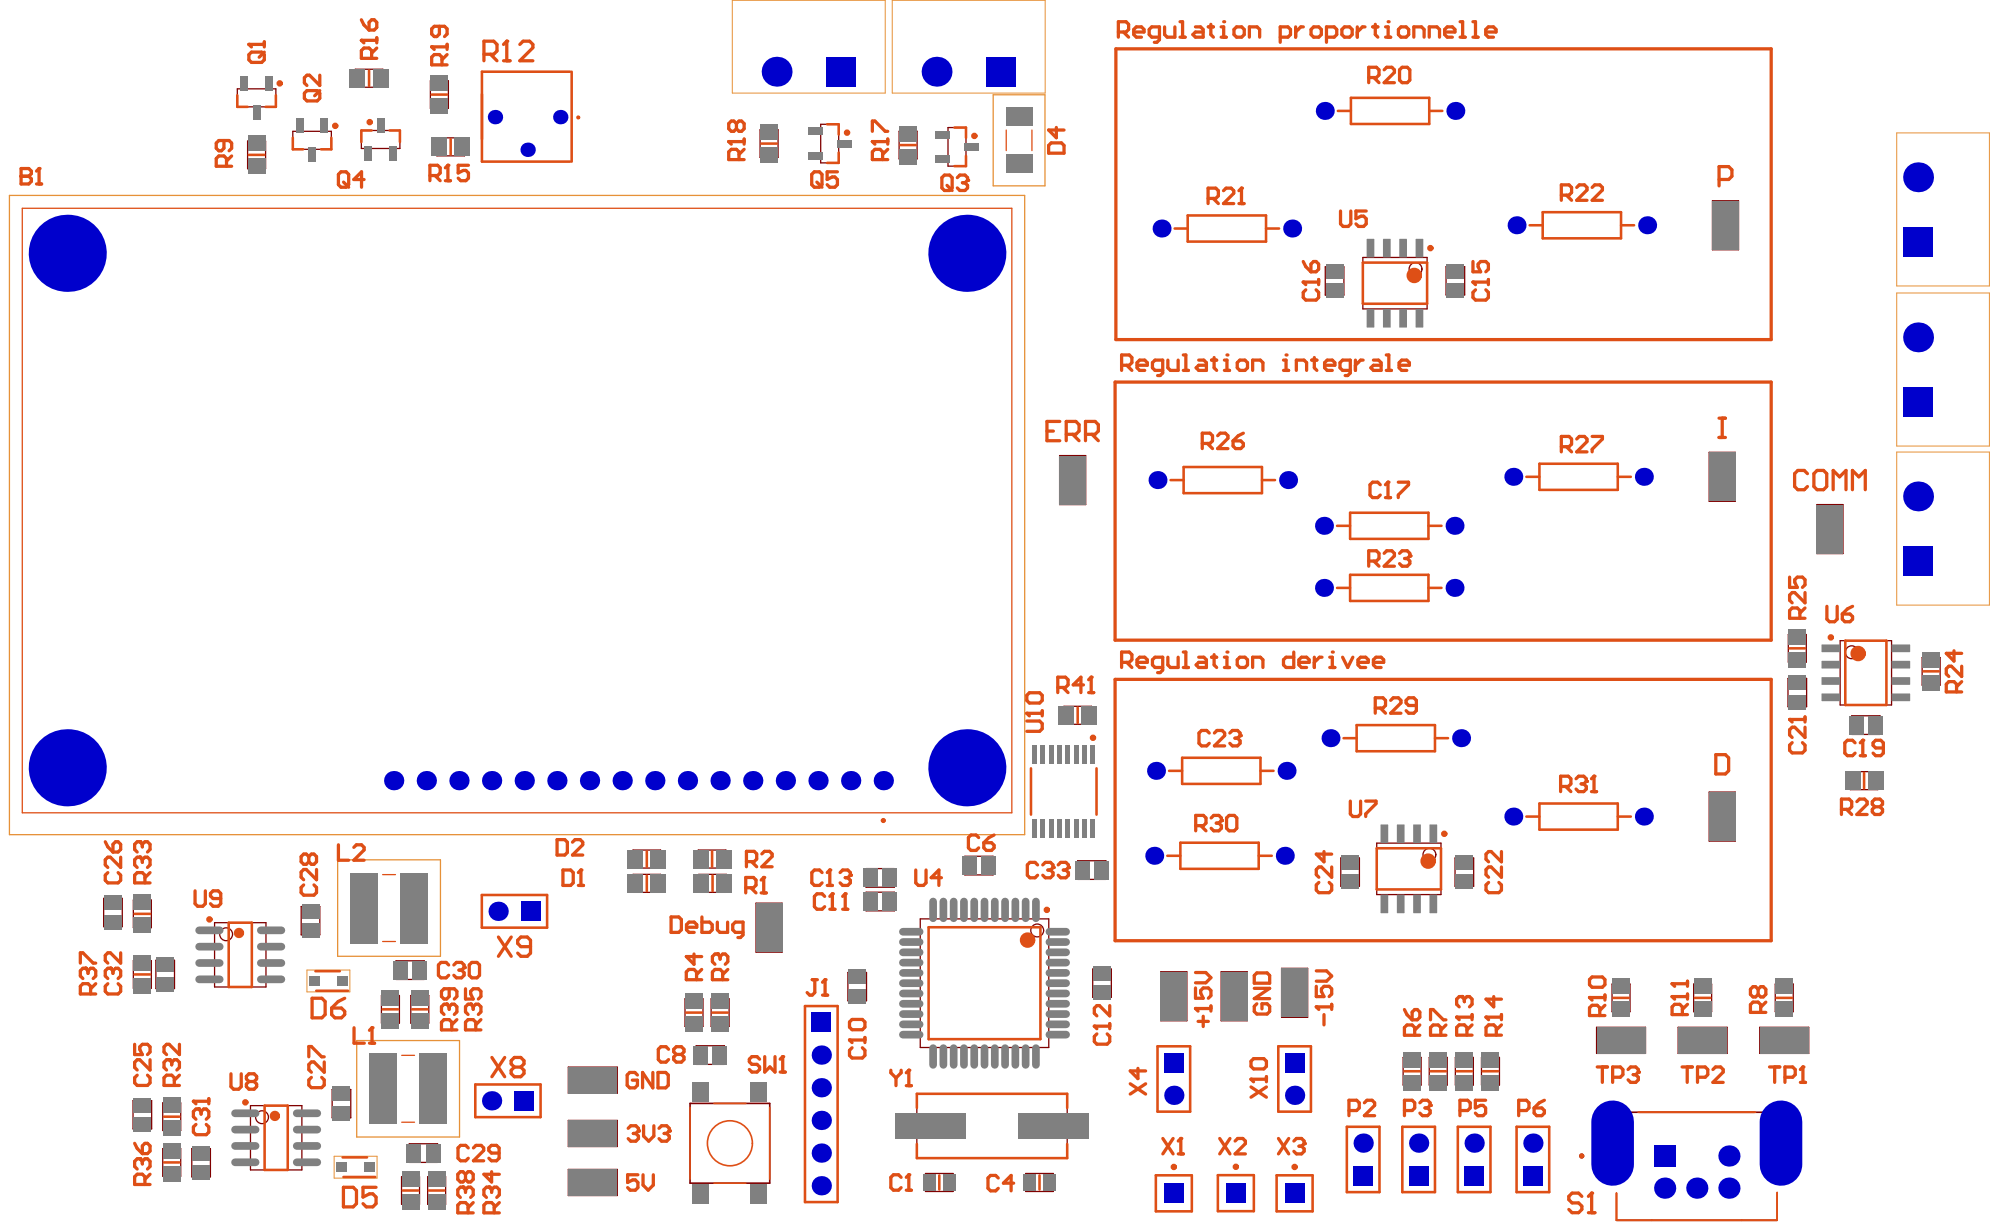
[picture p79: page 1]

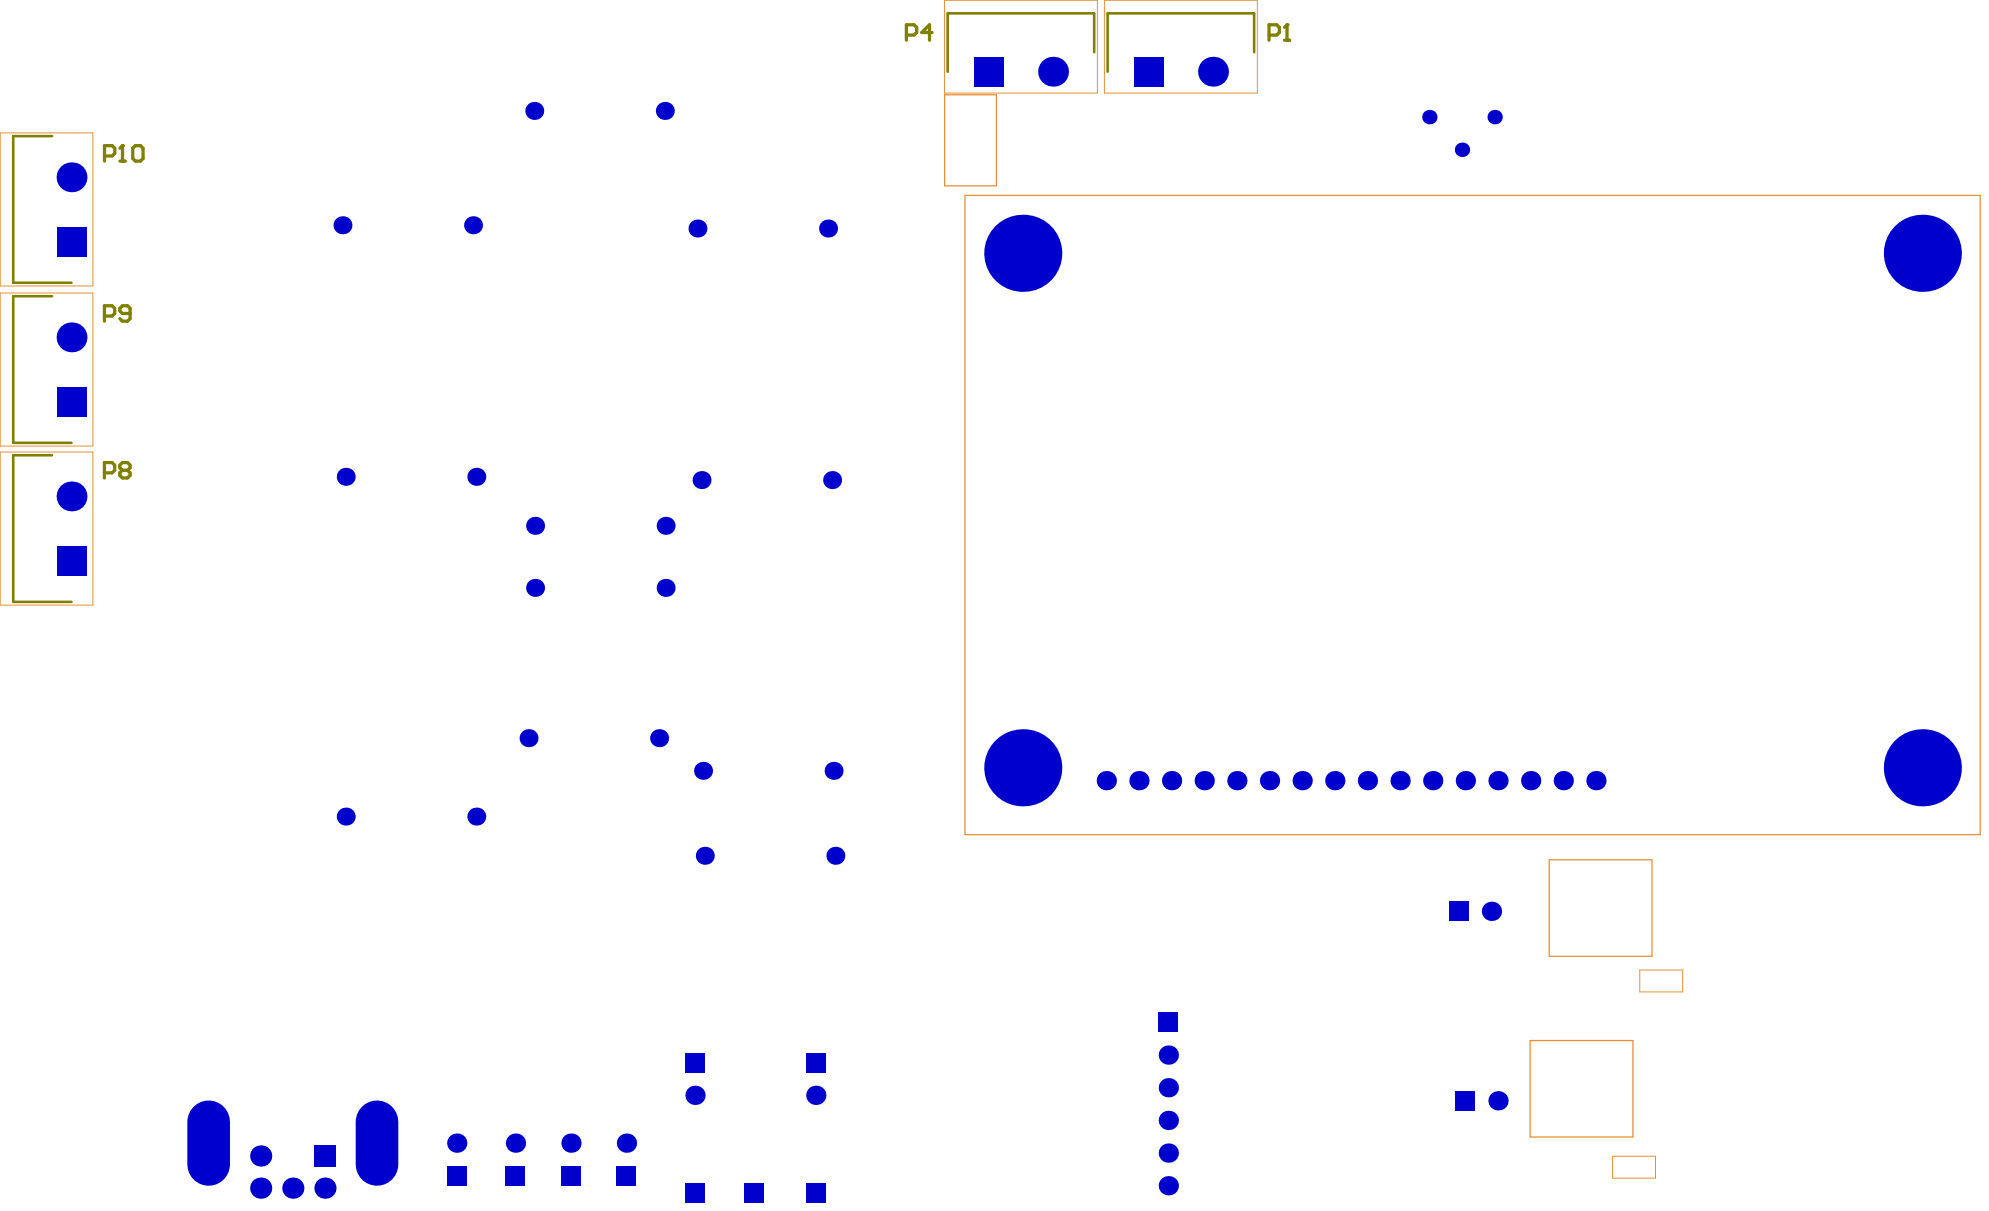
[picture p80: page 2]
