ETML-ES-SLO/PRJ_2226_Kit_RegulationThermique/(list of files, drawings)

Other design files:
2226A/hard/2226_RegThermique_1/2226_RegThermique.PrjPcb
2226A/hard/2226_RegThermique_1/2226_RegThermique.SCHLIB
2226A/hard/2226_RegThermique_1/Alimentation.SchDoc
2226A/hard/2226_RegThermique_1/Main_Sheet.SchDoc
2226A/hard/2226_RegThermique_1/PCB_RegThermique.PcbDoc
2226A/hard/2226_RegThermique_1/Regulation_PID.SchDoc
2226A/hard/2226_RegThermique_1/uC_HMI.SchDoc
2226A/hard/My_Library_2226/3362P_1.PcbLib
2226A/hard/My_Library_2226/JAN1N4108CUR1.PcbLib
2226A/hard/My_Library_2226/LCD/NHD0420AZFSWGBW33V3.PcbLib
2226A/hard/My_Library_2226/LCD/NHD-0420AZ-FSW-GBW-33V3.SchLib
2226A/hard/My_Library_2226/RHDRRA2W95P0X500_1X2_1120X900X1280P.PcbLib
2226A/hard/My_Library_2226/SDE0604A101K.PcbLib
2226A/hard/My_Library_2226/SODFL2513X70N.PcbLib
2226A/hard/My_Library_2226/XDCR_PEC12R-2220F-S0024.PcbLib
2226A/hard/PCB_Project/ES_Class6C_2L.PcbDoc
2226A/hard/PCB_Project/PCB_Project.PrjPcb
2226A/hard/Reg_Thermique_Capteur/Capteur_Therm.SchDoc
2226A/hard/Reg_Thermique_Capteur/Reg_therm_Capt.PcbDoc
2226A/hard/Reg_Thermique_Capteur/Reg_Thermique_Capteur.PrjPcb
2226A/hard/Reg_Thermique_Resist/Power_Resistor.SchDoc
2226A/hard/Reg_Thermique_Resist/Reg_therm_Res.PcbDoc
2226A/hard/Reg_Thermique_Resist/Reg_Thermique_Resist.PrjPcb
